sciciliani/magicWand/(commit log)

2026-09-30 Wait until 1.5 s after reset before starting Bluetooth
    Only BOOT_TRACE builds (1.5 s pause at the top of setup) had a working
    Bluetooth link. Reproduce the pause right before BLE.begin(), independent
    of Serial, to test whether timing is the cause.
    Claude-Session: https://claude.ai/code/session_018jHqSBAiWCJ9xuAdo1iBGv
    [comm.cpp, config.h]
2026-09-30 Always start the UART first at boot, like BOOT_TRACE
    USE_SERIAL 0 or BOOT_TRACE 0 left the app's Bluetooth link dead, and a
    1.5 s pause before BLE.begin() alone did not help. The only working start-up
    was BOOT_TRACE's: Serial.begin() + 1.5 s at the top of setup(). Do that on
    every boot and wake-up; USE_SERIAL now only controls printing.
    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
2026-09-30 Revert BYE hang-up: the wand does get the disconnect event
    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
    [MagicWand.ino, comm.cpp, comm.h]
2026-09-30 Restart Bluetooth right after the disconnect event, reset all link state
    onDisconnect() (which does fire) raises a flag; poll() restarts the stack
    right after BLE.poll() returns (it can't be restarted from inside its own
    handler). All per-link state is reset, retries if the restart fails,
    connection state comes from the events only (BLE.connected() can report
    the old link after a restart), and the motion stream stops on disconnect.
    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
    [MagicWand.ino, comm.cpp]
2026-09-30 On disconnect, restart the whole chip (quietly) instead of BLE.end/begin
    BLE.end() + BLE.begin() after the disconnect event hung the wand (the
    'restarting Bluetooth' line was the last thing printed). Restart the chip
    instead: ~2 s, no wake-up buzz (flag in backup RAM), and the next
    connection gets the same fresh state as the first one after power-up.
    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
    [MagicWand.ino, comm.cpp, power.cpp, power.h]
2026-09-30 Don't write into a dead link; watchdog restarts a frozen wand
    The freeze happened while the motion stream was mid-send when the app
    disconnected (the disconnect message printed, then nothing). notify() now
    stops as soon as the disconnect event clears linkUp and gives up after
    ~20 ms of full buffers. A 4 s hardware watchdog restarts the chip quietly
    if the loop still freezes (BOOT line says WATCHDOG).
    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
2026-09-30 Debug: print where the main loop is when the app disconnects
    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
2026-09-30 No Serial prints inside the disconnect handler
    It runs inside the Bluetooth stack: the first print got out, the second
    froze the wand until the watchdog restarted it. The handler only raises
    flags; poll() logs and restarts.
    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
2026-09-30 App: stop the motion stream before the page goes away
    Tab hidden (switching away or closing) -> STREAM 0 while the page can still
    send; visible again -> STREAM 1. Release wand also stops the stream first.
    A disconnect in the middle of a stream line froze the wand.
    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
2026-09-30 App: motion stream only while the Live tab is shown
    Switching to Spells/IR codes/Settings sends STREAM 0, back to Live sends
    STREAM 1 (and only if the page is visible).
    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
2026-09-30 BLE on the native Silicon Labs stack instead of ArduinoBLE
    ArduinoBLE's writeValue() never returned when the app dropped mid-send
    (loop froze in notify()), and GATT discovery hung on reconnects. comm.cpp
    now talks to the sl_bt API directly (Tools > Protocol stack > BLE (Silabs)):
    - sl_bt_on_event() only updates state and restarts advertising on
    disconnect; nothing slow runs in the stack's task.
    - Notifications are queued with sl_bt_gatt_server_send_notification(),
    which returns at once; full queue -> retry <= 20 ms, link gone -> drop.
    - Notification size follows the negotiated MTU (up to 244 bytes).
    - Disconnect clears all link state; unread bytes of the old link are
    discarded, a new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
2026-10-01 IR LED on D6 instead of D0
    D6 (PC6) is Serial1 TX, which the firmware never starts; USB Serial is on
    PA8/PA9. The IR carrier is bit-banged with digitalWrite, so any GPIO works.
    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
2026-10-01 IR: exact send/capture timing, 3-2-1-go countdown before learning
    Send: micros() on this core ticks in 30.5 us steps (32 kHz sleep timer),
    and the spaces between marks ran with interrupts on, so the Bluetooth
    stack could stretch a "0" into a "1". Each frame is now sent with
    interrupts off (IR_SEND_IRQ_OFF, default 1) and every edge is placed at
    an absolute cycle-counter time from the frame start.
    Learn: edges are timestamped with the cycle counter instead of micros(),
    and the chip is held in EM1 while listening (EM2 stops the counter).
    LEARN now counts down on the wand (tick buzz at 3, 2, 1, long buzz on
    go) before the receiver switches on; the app shows the count.
    Also: make app serves th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
    [MagicWand.ino, config.h, ir.cpp]
2026-10-01 IR: transmit like a held button for IR_HOLD_MS (300 ms)
    One bare frame (~70 ms) is easy to miss. Every send now keeps going for
    IR_HOLD_MS, as a real remote does on a normal press: NEC/LG codes send the
    frame once then "still held" repeat bursts every 108 ms (not a second
    press); other protocols repeat the full frame with their own gap.
    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
2026-10-01 IR: RCA protocol (56 kHz); learned codes get the right carrier
    The TV remote sends RCA codes (F2A0D5 = address F, command 2A, then both
    inverted). RCA uses a 56 kHz carrier; learned codes were always stored
    as 38 kHz, which a 56 kHz TV receiver barely sees.
    - HEX <c> rca <name> <hex>: 4/4 ms header, 500 us marks, 1/2 ms spaces.
    - Learning guesses the carrier from the format: RCA -> 56 kHz,
    Sony -> 40 kHz, everything else 38 kHz.
    - Library: TV > RCA (power, volume, channel).
    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
    [MagicWand.ino, ir.cpp, ir.h, test_ir_codec.cpp]
2026-10-01 IR debug: raw capture dump (IRDUMP) and protocol name in IRCODE
    After every LEARN (IR_DEBUG 1) the Serial Monitor gets the capture exactly
    as received: mark/space pairs in us, a line per frame. The IRDUMP command
    prints the last capture again. Serial only, never sent to the app.
    IRCODE lines now name the protocol guessed from the timings (NEC, RCA,
    Samsung, Sony, Coolix, Panasonic, or generic).
    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
2026-10-01 IRDUMP: one short line (code, repeats, kHz) instead of the raw pulse dump
    After LEARN (IR_DEBUG 1): "IRDUMP code F2A0D5 repeats 3 56 kHz".
    IRDUMP prints the last learned code again, IRDUMP <c> a stored slot.
    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
    [MagicWand.ino, config.h, ir.cpp, ir.h]
2026-10-01 App shows the captured code: hex, repeats, kHz
    LEARN ok now carries them ("LEARN 0 ok 24 F2A0D5 3 56"). The app shows
    them in a toast, in the library dialog, and under the slot in IR codes
    (until the slot is replaced or cleared).
    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
    [MagicWand.ino]
2026-10-01 IR learn/replay the IrDump way
    The wand learned 0x4E01F where IrDump saw 0xB24D7B84E01F x2: the receiver
    switched on after the GO buzz, the first frame was caught half-way, and
    the decoder kept the first frame it saw.
    - Receiver powers on at the start of the countdown (settled by GO),
    capture ends after 200 ms of silence, buffer 1000 edges (as IrDump).
    - Decode splits frames like IrDump and keeps the most complete one,
    counting how many times it came (x2).
    - Send replays that frame x repeats, nothing more (no 300 ms hold, no
    NEC repeat bursts).
    - Serial and app print it in IrDump's format: 0xB24D7B84E01F x2 38kHz.
    Claude-Session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
    [MagicWand.ino, config.h, ir.cpp, ir.h, test_ir_codec.cpp]
2026-10-01 IR LED on several pins at once (IR_LED_PINS) for more range, no extra parts
    One pin gives the LED ~10 mA and the MG24 has no drive-strength setting.
    IR_LED_PINS lists free port-C pins (D0, D4, D5, D6) that are switched in a
    single register write (GPIO_PortOutSet/Clear), so they share the load:
    4 pins bridged together + a 33R resistor = ~4-5x the light. Default {D6}:
    nothing changes until the pins are wired. D1 is always skipped.
    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
    [Arduino.h, config.h, ir.cpp, ir.h, power.cpp, test_ir_codec.cpp]
2026-10-01 Adding 3pins for irda led power
